daprice/AlterErgo/PCB/AlterErgo.kicad_pcb

## KiCad design PCB/AlterErgo.kicad_pcb (2018-07-05)

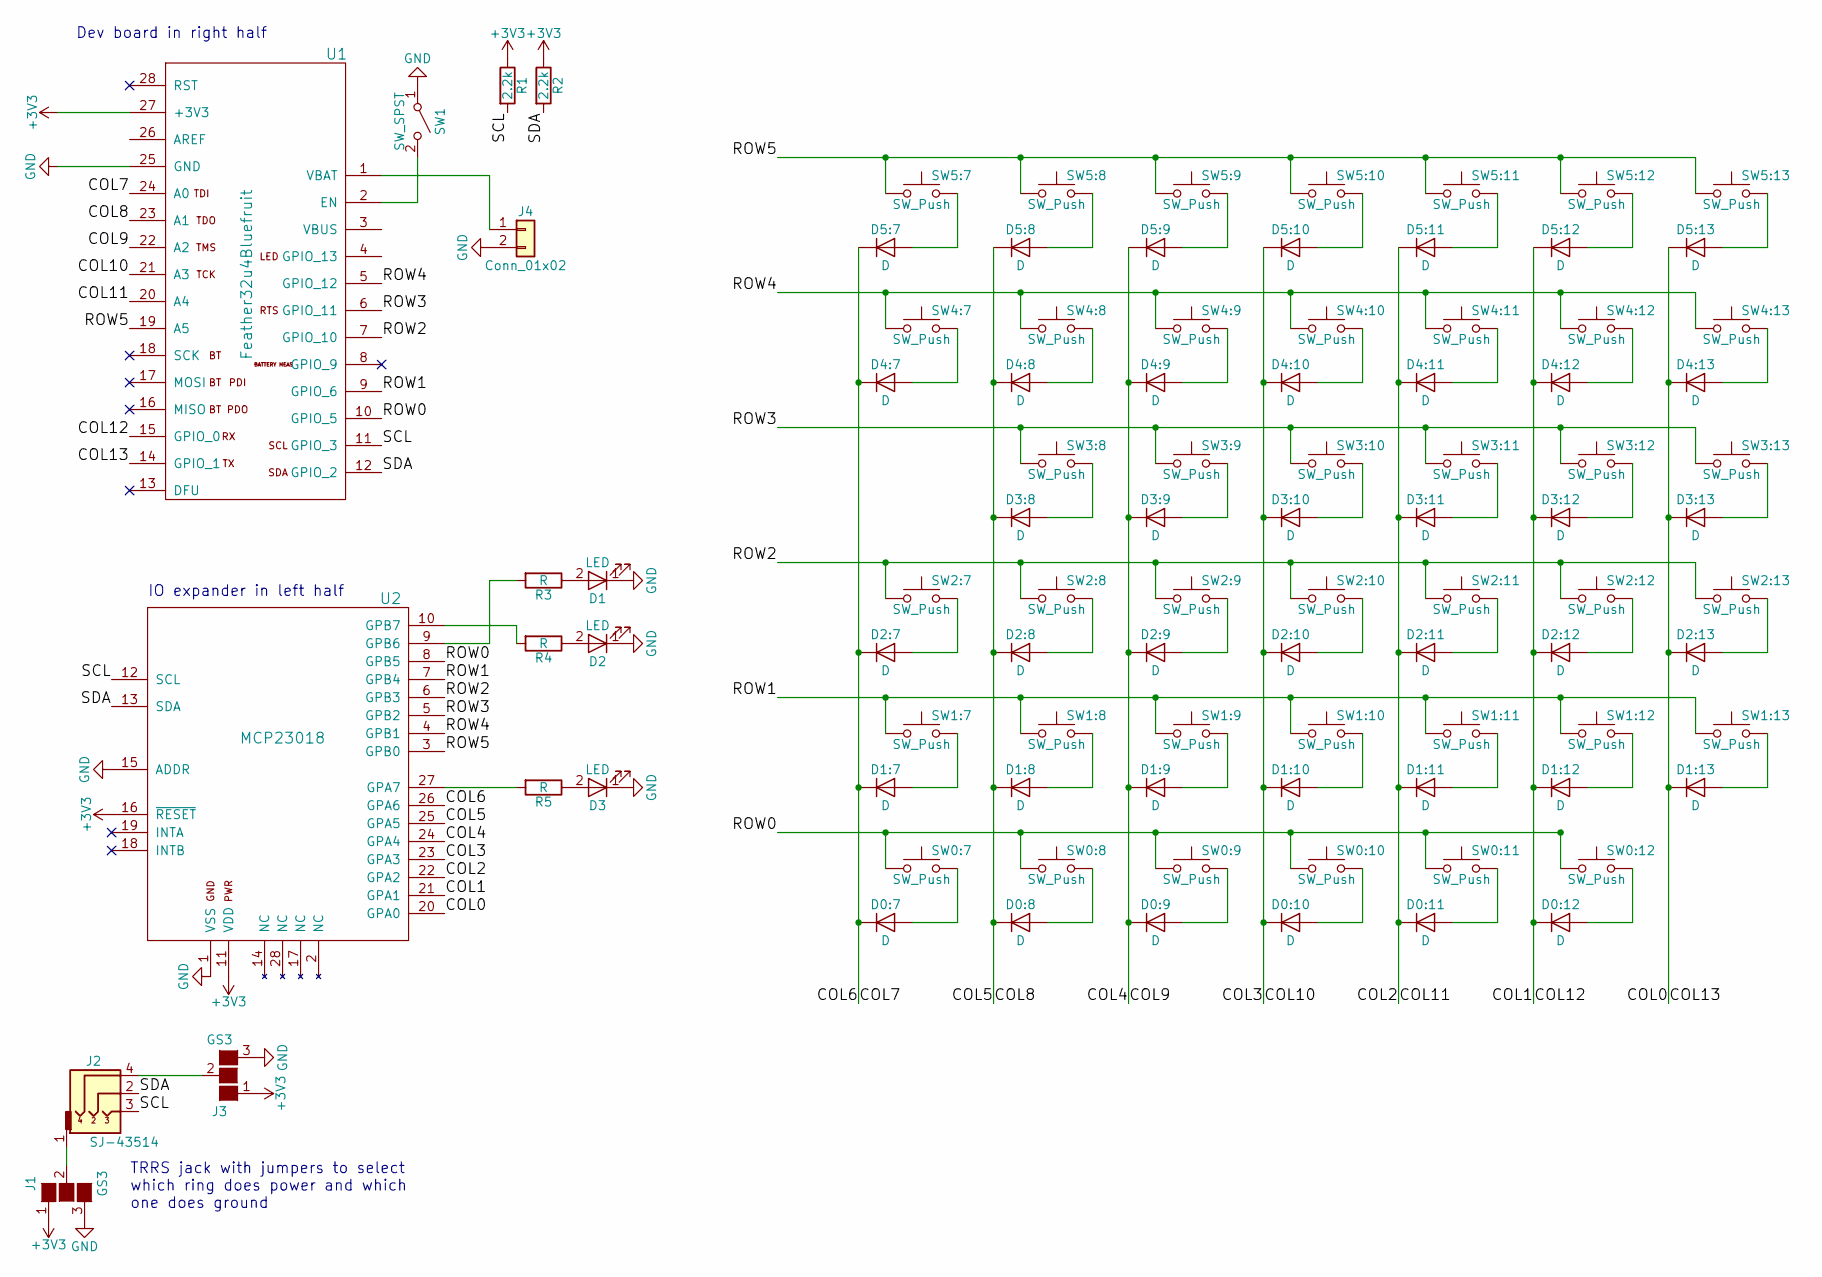
[picture p1: schematic AlterErgo.sch]

Parts:
D0:7, D0:8, D0:9, D0:10, D0:11, D0:12, D1:7, D1:8, D1:9, D1:10, D1:11, D1:12, D1:13, D2:7, D2:8, D2:9, D2:10, D2:11, D2:12, D2:13, D3:8, D3:9, D3:10, D3:11, D3:12, D3:13, D4:7, D4:8, D4:9, D4:10, D4:11, D4:12, D4:13, D5:7, D5:8, D5:9, D5:10, D5:11, D5:12, D5:13: D; D_SOD-123
D1, D2, D3: LED; LED_D3.0mm
J1, J3: GS3
J2: SJ-43514; TRRS_Jack_SJ-43514_reversible
J4: Conn_01x02; JST_PH_S2B-PH-SM4-TB_02x2.00mm_Angled
R1, R2: 2.2k; R_Axial_DIN0207_L6.3mm_D2.5mm_P7.62mm_Horizontal
R3, R4, R5: R; R_Axial_DIN0207_L6.3mm_D2.5mm_P7.62mm_Horizontal
SW0:7, SW0:8, SW0:9, SW0:10, SW0:11, SW0:12, SW1:7, SW1:8, SW1:9, SW1:10, SW1:11, SW1:12, SW1:13, SW2:7, SW2:8, SW2:9, SW2:10, SW2:11, SW2:12, SW2:13, SW3:8, SW3:9, SW3:10, SW3:11, SW3:12, SW3:13, SW4:7, SW4:8, SW4:9, SW4:10, SW4:11, SW4:12, SW4:13, SW5:7, SW5:8, SW5:9, SW5:10, SW5:11, SW5:12, SW5:13: SW_Push; Kailh_socket_optional_reversible
SW1: SW_SPST; GPTS_SPST_Pushbutton
U1: Feather32u4Bluefruit
U2: MCP23018; DIP-28_W7.62mm

Connections:
+3V3: J1.1 (G1), J3.1 (G1), R1.1, R2.1, U1.27 (+3V3), U2.11 (VDD), U2.16 (~RESET)
/COL0: D1:13.1 (K), D2:13.1 (K), D3:13.1 (K), D4:13.1 (K), D5:13.1 (K), U1.14 (GPIO_1), U2.20 (GPA0)
/COL1: D0:12.1 (K), D1:12.1 (K), D2:12.1 (K), D3:12.1 (K), D4:12.1 (K), D5:12.1 (K), U1.15 (GPIO_0), U2.21 (GPA1)
/COL4: D0:9.1 (K), D1:9.1 (K), D2:9.1 (K), D3:9.1 (K), D4:9.1 (K), D5:9.1 (K), U1.22 (A2), U2.24 (GPA4)
/COL5: D0:8.1 (K), D1:8.1 (K), D2:8.1 (K), D3:8.1 (K), D4:8.1 (K), D5:8.1 (K), U1.23 (A1), U2.25 (GPA5)
/COL6: D0:7.1 (K), D1:7.1 (K), D2:7.1 (K), D4:7.1 (K), D5:7.1 (K), U1.24 (A0), U2.26 (GPA6)
/COL10: D0:10.1 (K), D1:10.1 (K), D2:10.1 (K), D3:10.1 (K), D4:10.1 (K), D5:10.1 (K), U1.21 (A3), U2.23 (GPA3)
/COL11: D0:11.1 (K), D1:11.1 (K), D2:11.1 (K), D3:11.1 (K), D4:11.1 (K), D5:11.1 (K), U1.20 (A4), U2.22 (GPA2)
/ROW0: SW0:7.1, SW0:8.1, SW0:9.1, SW0:10.1, SW0:11.1, SW0:12.1, U1.10 (GPIO_5), U2.8 (GPB5); also elsewhere on the board
/ROW1: SW1:7.1, SW1:8.1, SW1:9.1, SW1:10.1, SW1:11.1, SW1:12.1, SW1:13.1, U1.9 (GPIO_6), U2.7 (GPB4); also elsewhere on the board
/ROW2: SW2:7.1, SW2:8.1, SW2:9.1, SW2:10.1, SW2:11.1, SW2:12.1, SW2:13.1, U1.7 (GPIO_10), U2.6 (GPB3); also elsewhere on the board
/ROW3: SW3:8.1, SW3:9.1, SW3:10.1, SW3:11.1, SW3:12.1, SW3:13.1, U1.6 (GPIO_11), U2.5 (GPB2); also elsewhere on the board
/ROW4: SW4:7.1, SW4:8.1, SW4:9.1, SW4:10.1, SW4:11.1, SW4:12.1, SW4:13.1, U1.5 (GPIO_12), U2.4 (GPB1); also elsewhere on the board
/ROW5: SW5:7.1, SW5:8.1, SW5:9.1, SW5:10.1, SW5:11.1, SW5:12.1, SW5:13.1, U1.19 (A5), U2.3 (GPB0); also elsewhere on the board
/SCL: J2.3, R1.2, U1.11 (GPIO_3), U2.12 (SCL)
/SDA: J2.2, R2.2, U1.12 (GPIO_2), U2.13 (SDA)
GND: D1.1 (K), D2.1 (K), D3.1 (K), J1.3 (G3), J3.3 (G3), J4.2, SW1.1 (A), U1.25 (GND), U2.1 (VSS), U2.15 (ADDR); also elsewhere on the board
unnamed: D0:7.2 (A), SW0:7.2
unnamed: D0:8.2 (A), SW0:8.2
unnamed: D0:9.2 (A), SW0:9.2
unnamed 20: D0:10.2 (A), SW0:10.2; also elsewhere on the board
unnamed 21: D0:11.2 (A), SW0:11.2; also elsewhere on the board
unnamed: D0:12.2 (A), SW0:12.2
unnamed: D1.2 (A), R3.1
unnamed: D1:7.2 (A), SW1:7.2
unnamed: D1:8.2 (A), SW1:8.2
unnamed: D1:9.2 (A), SW1:9.2
unnamed: D1:10.2 (A), SW1:10.2
unnamed: D1:11.2 (A), SW1:11.2
unnamed: D1:12.2 (A), SW1:12.2
unnamed 30: D1:13.2 (A), SW1:13.2; also elsewhere on the board
unnamed: D2.2 (A), R4.1
unnamed: D2:7.2 (A), SW2:7.2
unnamed: D2:8.2 (A), SW2:8.2
unnamed: D2:9.2 (A), SW2:9.2
unnamed: D2:10.2 (A), SW2:10.2
unnamed: D2:11.2 (A), SW2:11.2
unnamed: D2:12.2 (A), SW2:12.2
unnamed 38: D2:13.2 (A), SW2:13.2; also elsewhere on the board
unnamed: D3.2 (A), R5.1
unnamed: D3:8.2 (A), SW3:8.2
unnamed: D3:9.2 (A), SW3:9.2
unnamed: D3:10.2 (A), SW3:10.2
unnamed: D3:11.2 (A), SW3:11.2
unnamed: D3:12.2 (A), SW3:12.2
unnamed 45: D3:13.2 (A), SW3:13.2; also elsewhere on the board
unnamed: D4:7.2 (A), SW4:7.2
unnamed: D4:8.2 (A), SW4:8.2
unnamed: D4:9.2 (A), SW4:9.2
unnamed: D4:10.2 (A), SW4:10.2
unnamed: D4:11.2 (A), SW4:11.2
unnamed: D4:12.2 (A), SW4:12.2
unnamed 52: D4:13.2 (A), SW4:13.2; also elsewhere on the board
unnamed: D5:7.2 (A), SW5:7.2
unnamed: D5:8.2 (A), SW5:8.2
unnamed: D5:9.2 (A), SW5:9.2
unnamed: D5:10.2 (A), SW5:10.2
unnamed: D5:11.2 (A), SW5:11.2
unnamed: D5:12.2 (A), SW5:12.2
unnamed 59: D5:13.2 (A), SW5:13.2; also elsewhere on the board
unnamed: J1.2 (G2), J2.1
unnamed: J2.4, J3.2 (G2)
unnamed 62: J4.1, U1.1 (VBAT); also elsewhere on the board
unnamed: R3.2, U2.9 (GPB6)
unnamed: R4.2, U2.10 (GPB7)
unnamed: R5.2, U2.27 (GPA7)
unnamed: SW1.2 (B), U1.2 (EN)

Notes on the sheet:
TRRS jack with jumpers to select which ring does power and which one does ground
IO expander in left half
Dev board in right half

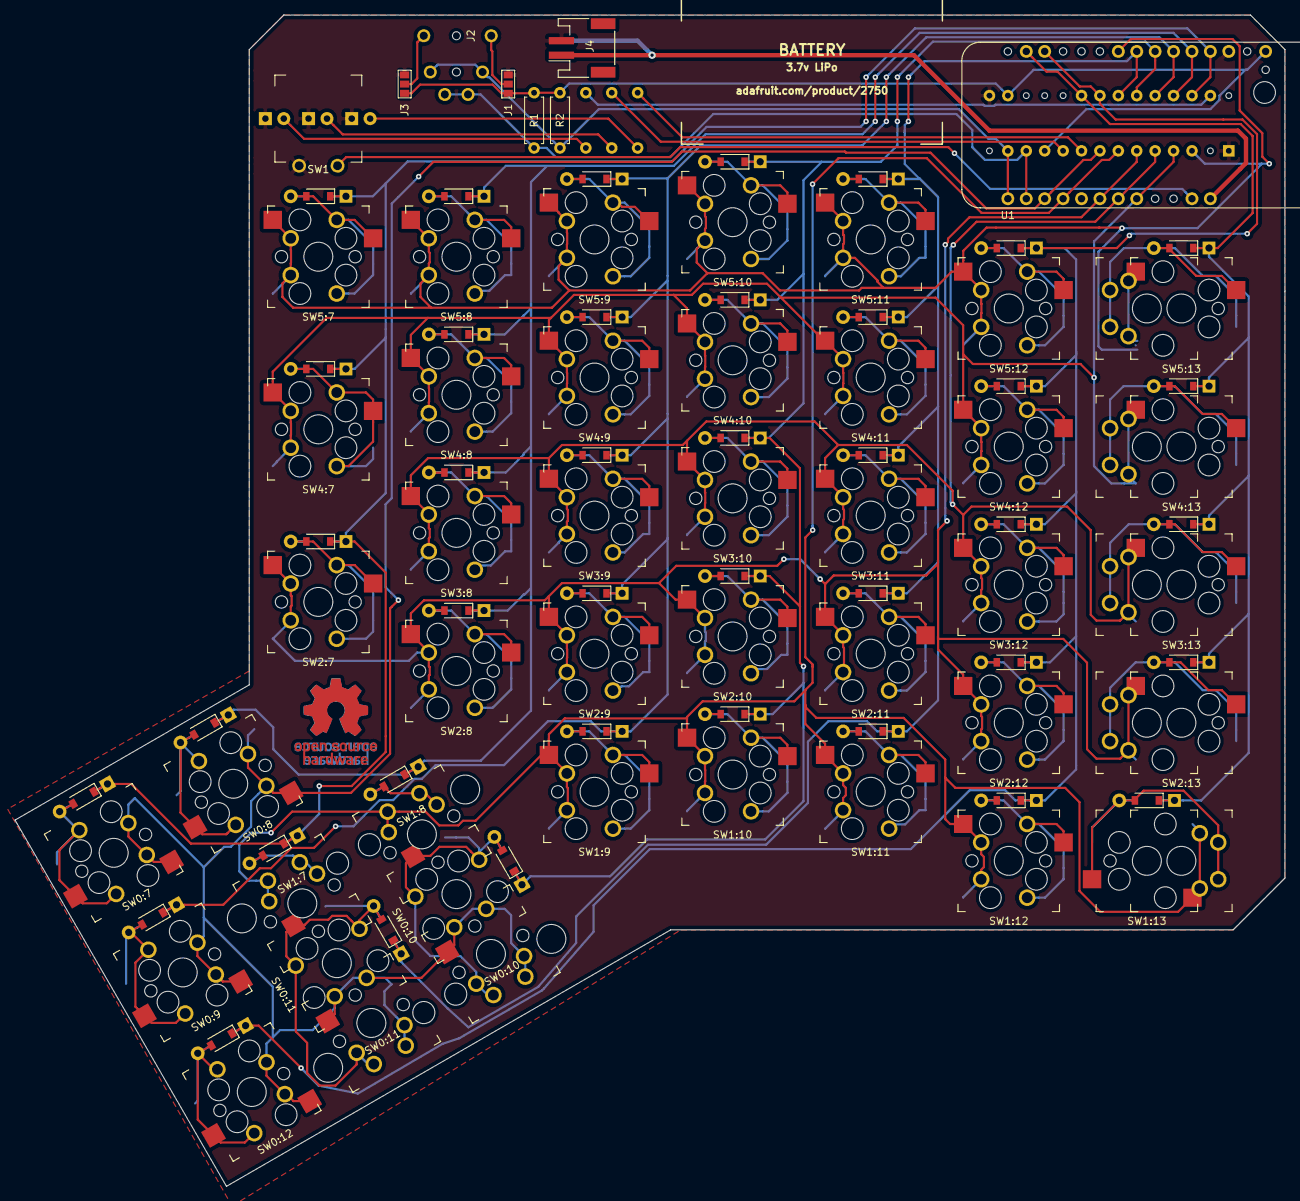
[picture p2: board AlterErgo.kicad_pcb from above]

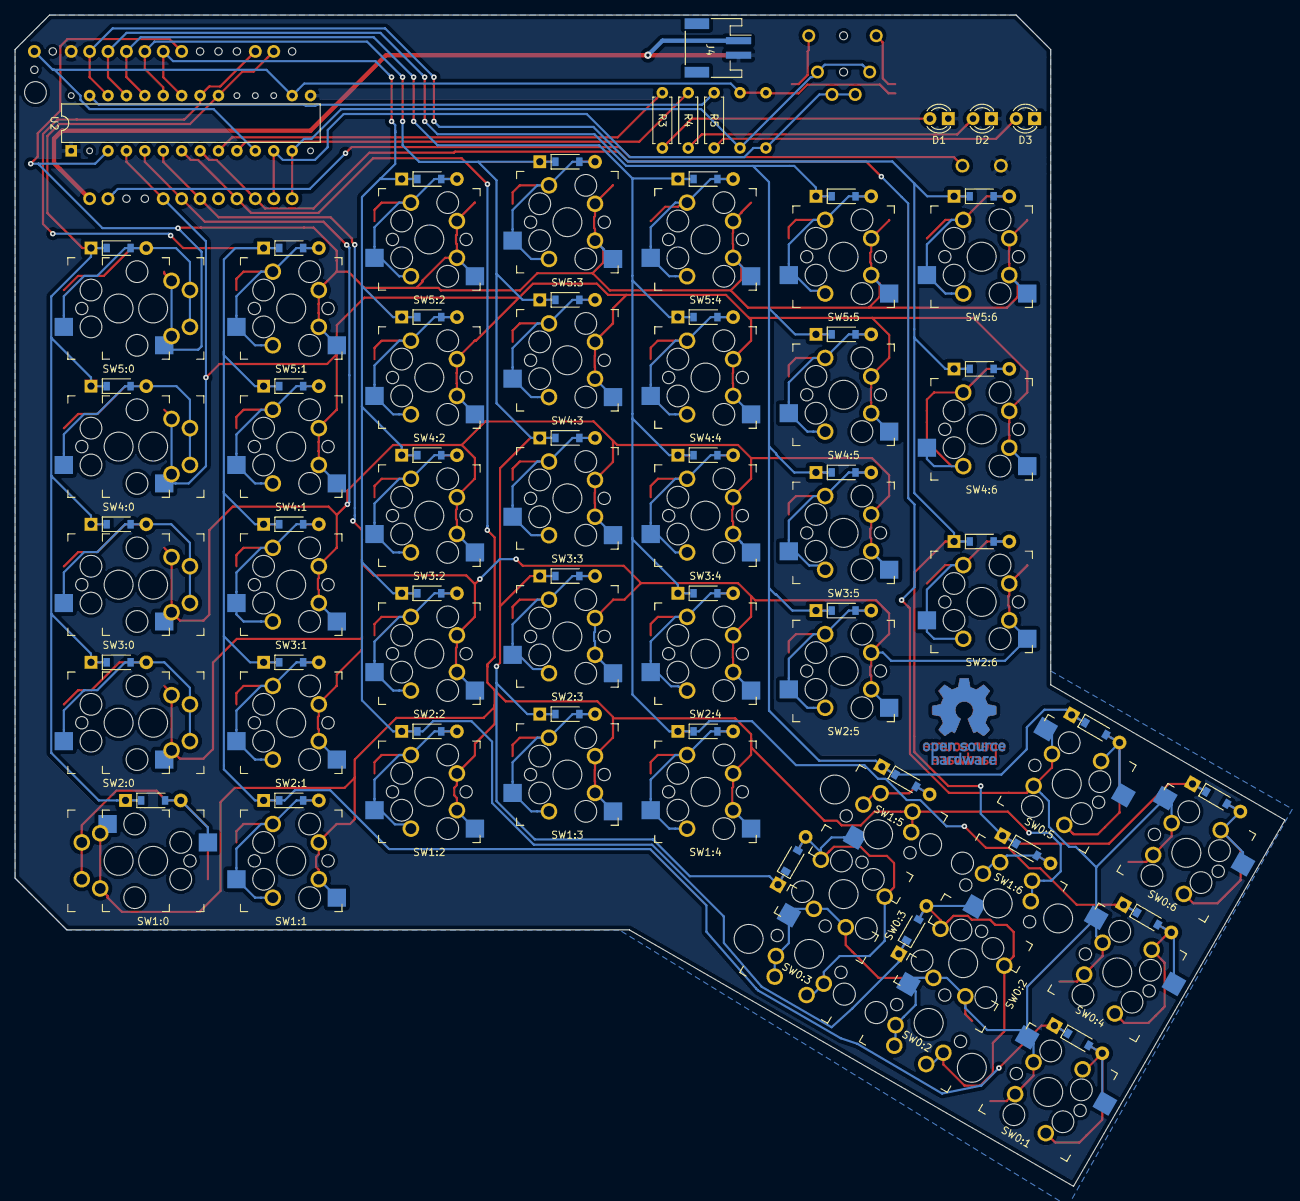
[picture p3: board AlterErgo.kicad_pcb from below]

Board: 2 copper layers, 175.2 x 161.6 mm, 106 parts (8 on the bottom side), 67 nets.

Other parts of the board:
J4#2: Conn_01x02; JST_PH_S2B-PH-SM4-TB_02x2.00mm_Angled
RESET: ResetHole; MountingHole_3mm
SW0:10#2, SW0:11#2: SW_Push; MX_reversible
SW1:13#2, SW2:13#2, SW4:13#2, SW5:13#2: SW_Push; MX_reversible_minimal
SW3:13#2: SW_Push; Kailh_socket_reversible_nohole
Stab0:10, Stab0:11: SW_Stabilizer; MX_Stabilizer_2u

Their connections:
/ROW0: SW0:10#2.1, SW0:11#2.1; also elsewhere on the board
/ROW1: SW1:13#2.1; also elsewhere on the board
/ROW2: SW2:13#2.1; also elsewhere on the board
/ROW3: SW3:13#2.1; also elsewhere on the board
/ROW4: SW4:13#2.1; also elsewhere on the board
/ROW5: SW5:13#2.1; also elsewhere on the board
GND: J4#2.2; also elsewhere on the board
unnamed 20: SW0:10#2.2; also elsewhere on the board
unnamed 21: SW0:11#2.2; also elsewhere on the board
unnamed 30: SW1:13#2.2; also elsewhere on the board
unnamed 38: SW2:13#2.2; also elsewhere on the board
unnamed 45: SW3:13#2.2; also elsewhere on the board
unnamed 52: SW4:13#2.2; also elsewhere on the board
unnamed 59: SW5:13#2.2; also elsewhere on the board
unnamed 62: J4#2.1; also elsewhere on the board
