daprice/AlterErgo/(commit log)

2018-03-27 Design key matrix and add necessary IC schematics
    [AlterErgo.kicad_pcb, AlterErgo.sch]
2018-04-03 Add TRRS jack to schematic; annotate matrix diodes
    [AlterErgo.sch]
2018-04-09 Associate most components with footprints
    [AlterErgo.sch]
2018-05-15 Assign all components to footprints; generate netlist
    [AlterErgo.sch]
2018-06-12 Position non-angled switches on PCB
    [AlterErgo.kicad_pcb, AlterErgo.sch]
2018-06-13 Position thumb cluster switches;
    The formulas I used to convert from Keyboard Layout Editor’s U (key units) with center of rotation to absolute coordinates in inches for KiCad can be found in https://www.icloud.com/numbers/0NN-61zf81eeyGf2WznQMhHeA#Key_position_calculations
    [AlterErgo.kicad_pcb]
2018-06-13 Allow use of 1u or 1.5u keys in all positions on outside column (using the alternate positions will require soldering and will not allow kailh sockets to be used)
    [AlterErgo.kicad_pcb]
2018-06-13 Set up design rules
    based on https://docs.oshpark.com/design-tools/kicad/kicad-design-rules/
    [AlterErgo.kicad_pcb]
2018-06-13 Add stabilizer mounting holes to 2U keys in thumb cluster
    [AlterErgo.kicad_pcb]
2018-06-13 Actually use .75in for key spacing (d'oh!)
    [AlterErgo.kicad_pcb]
2018-06-13 Avoid overlapping holes for switches that have alternate mounting options
    Unfortunately this means that the outer column will *require* socket mounting for the default positions and soldering for the alternate positions, instead of allowing either method
    [AlterErgo.kicad_pcb]
2018-06-13 Flip switch labels to the correct side for right hand
    [AlterErgo.kicad_pcb]
2018-06-14 Change diodes to use 2-sided footprint
    [AlterErgo.kicad_pcb]
2018-06-14 Position power switch, LEDs, TRRS jack, resistors
    [AlterErgo.kicad_pcb]
2018-06-14 Rework row/col pin assignments on Feather to line up better with those on the i/o expander
    [AlterErgo.kicad_pcb, AlterErgo.sch]
2018-06-14 Position diodes
    [AlterErgo.kicad_pcb]
2018-06-14 Hide diode reference numbers from silkscreen; add left hand side's switch reference numbers
    [AlterErgo.kicad_pcb]
2018-06-14 Show switch footprint graphics on both sides of the PCB
    [AlterErgo.kicad_pcb]
2018-06-14 Fix pin numbers to match with overlapping pads on outer row
    [AlterErgo.kicad_pcb]
2018-06-14 Initial attempt at routing traces in upper area
    [AlterErgo.kicad_pcb, AlterErgo.sch]
2018-06-14 Route columns
    [AlterErgo.kicad_pcb]
2018-06-15 Route rows
    [AlterErgo.kicad_pcb]
2018-06-15 Correct some vias too close to other tracks
    [AlterErgo.kicad_pcb]
2018-06-15 Adjust outer column socket footprint to avoid overlapping drill holes
    [AlterErgo.kicad_pcb]
2018-06-15 Fix some DRC errors
    [AlterErgo.kicad_pcb]
2018-06-15 Use non-plated thru holes (NPTH) for unused microcontroller/IO expander pins
    [AlterErgo.kicad_pcb]
2018-06-16 Accept through hole or surface mount 1N4148 diodes; clean up some routing slightly
    [AlterErgo.kicad_pcb]
2018-06-17 Add hole to allow Feather reset button to be pressed even when installed upside-down on the left-hand PCB
    [AlterErgo.kicad_pcb]
2018-06-17 Allow mounting of battery connector on either side of PCB
    [AlterErgo.kicad_pcb]
2018-06-20 Fix footprints for alternate outer column positions so kicad recognizes the pins as needing to be connected
    [AlterErgo.kicad_pcb]
2018-06-20 Move thumb cluster slightly
    With key wobble, the innermost 2u thumb key and the closest key in the bottom row would have probably rubbed against each other, so moved the thumb cluster outward from the rest of the keyboard slightly
    [AlterErgo.kicad_pcb]
2018-07-05 Add board outline; adjust position of components; adjust routing of some traces; add ground planes; add OSHW logo
    SW1 (power toggle) was moved down to match the key spacing. TRRS jack was moved up to match the edge of the board. The traces that were moved were moved in order to allow better ground plane fill and clean up some around the thumb cluster.
    [AlterErgo.kicad_pcb]
